Mirginia0/Model-of-Self-Balancing-Multi-Rotor-Beam/ReadMe.md

<h1>Self-Balancing Multi-Rotor Beam</h1>
<p>The goal of this project was to build a self-balancing beam as a laboratory platform for testing and comparing control algorithms. A sensor measures the beam’s tilt angle, while two motor-driven propellers generate differential thrust to control its position.</p>
<p>The physical prototype makes it possible to observe and compare controller responses to reference-angle changes and external disturbances.</p>
<p>Developed as a bachelor’s thesis in Automatic Control and Robotics at Poznan University of Technology (2026).</p>
<p><strong>Authors:</strong> Martyna Rydczak and Maciej Jaśtak<br><strong>Supervisor:</strong> dr inż. Bartłomiej Wicher</p>
<p><strong>ESP32 · C++ · Python · MPU6050 · P/PI control</strong></p>
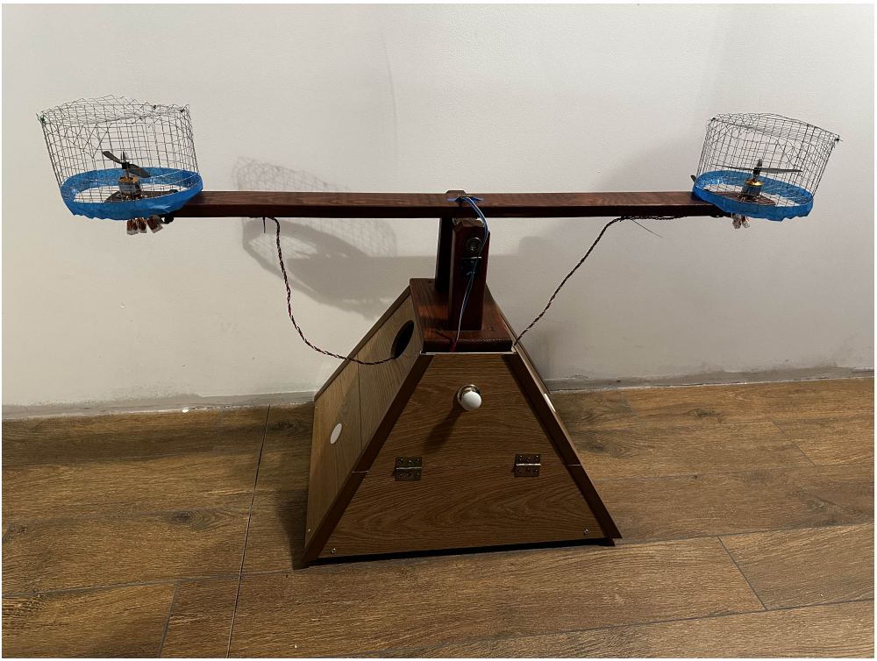
[picture p1: media/images/beam-overview.png]
The assembled beam with motors and protective enclosures

<p>The physical prototype with both propulsion units and protective enclosures.</p>
<h2>See it in action</h2>
<table><tr><th>Experiment</th><th>P controller</th><th>PI controller</th></tr><tr><td>Recovery after deflection</td><td><a href="media/videos/recovery-p.mp4?raw=true">Watch P</a></td><td><a href="media/videos/recovery-pi.mp4?raw=true">Watch PI</a></td></tr><tr><td>Ground-effect disturbance</td><td><a href="media/videos/ground-effect-p.mp4?raw=true">Watch P</a></td><td><a href="media/videos/ground-effect-pi.mp4?raw=true">Watch PI</a></td></tr><tr><td>Reference-angle changes</td><td><a href="media/videos/reference-angle-p.mp4?raw=true">Watch P</a></td><td><a href="media/videos/reference-angle-pi.mp4?raw=true">Watch PI</a></td></tr></table>
<p>Recordings of the three experiments with P and PI control. Links open the MP4 files for playback or download.</p>
<p>The ESP32 estimates beam angle from accelerometer measurements and adjusts both motor commands. A custom Python terminal allows live tuning and records measurements for analysis.</p>
<blockquote><h2>My contribution · Martyna Rydczak</h2>
<p>I was responsible for the electronics, propulsion integration, all software and experimental evaluation.</p>
<p><strong>Hardware integration.</strong> I selected the electronic and propulsion components, assembled and wired the system, and mounted the motors, propellers and protective enclosures on the wooden beam structure. I integrated the MPU6050 sensor with the ESP32 and connected the controller to both ESCs.</p>
<p><strong>Embedded software.</strong> I wrote the complete ESP32 firmware in C++. This included accelerometer-based angle estimation, startup offset calibration, low-pass filtering and the controller that generates differential motor commands. I implemented adjustable gains, individual motor trims, output limits and serial commands for operating and tuning the prototype.</p>
<p><strong>Measurement and evaluation.</strong> I developed the Python terminal and logger to change settings during experiments and record the measured angle, reference angle, controller gains and motor commands. I tuned the P and PI controllers on the physical stand, carried out the tests, collected the data and prepared the plots used to compare their responses. I also created the electronic system and control architecture diagrams in vector graphics.</p>
</blockquote>
<blockquote><p><strong>Maciej Jaśtak’s contribution</strong></p><p>Maciej built the wooden support and beam structure and prepared the mathematical calculations for the joint thesis.</p></blockquote>
<h2>How it works</h2>
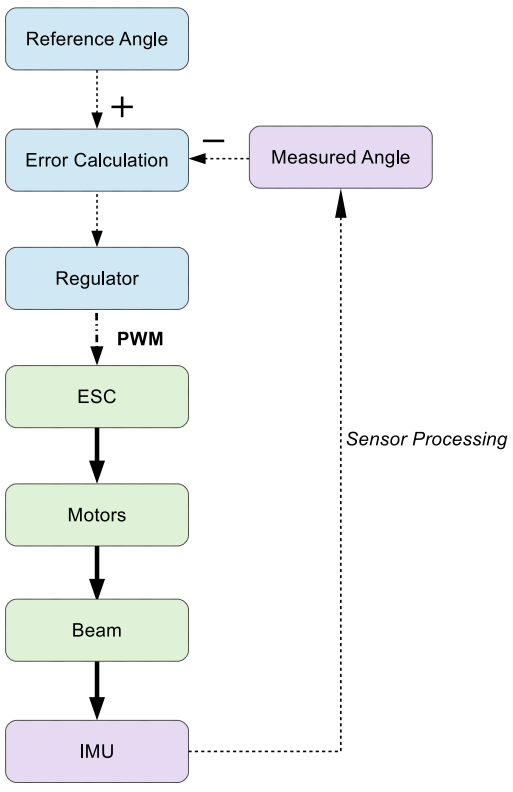
[picture p2: media/images/control-architecture.png]
Control-loop diagram created by Martyna Rydczak
<table><tr><td align="center" valign="middle"></td><td valign="middle"><table><thead><tr><th width="110">Arrow</th><th>Signal type</th></tr></thead><tbody><tr><td nowrap><code>····&gt;</code></td><td>Information signal</td></tr><tr><td nowrap><code>-·-·&gt;</code></td><td>PWM control signal</td></tr><tr><td nowrap><code>━━&gt;</code></td><td>Physical interaction</td></tr></tbody></table></td></tr></table><p>My control-loop diagram from the thesis presentation. The diagram uses reference minus measured angle; the firmware uses measured minus reference with corresponding motor output signs.</p>
<p>The firmware includes startup angle calibration, individual motor trims and adjustable controller gains. The reported experiments used P and PI control with <code>Kd = 0</code>.</p>
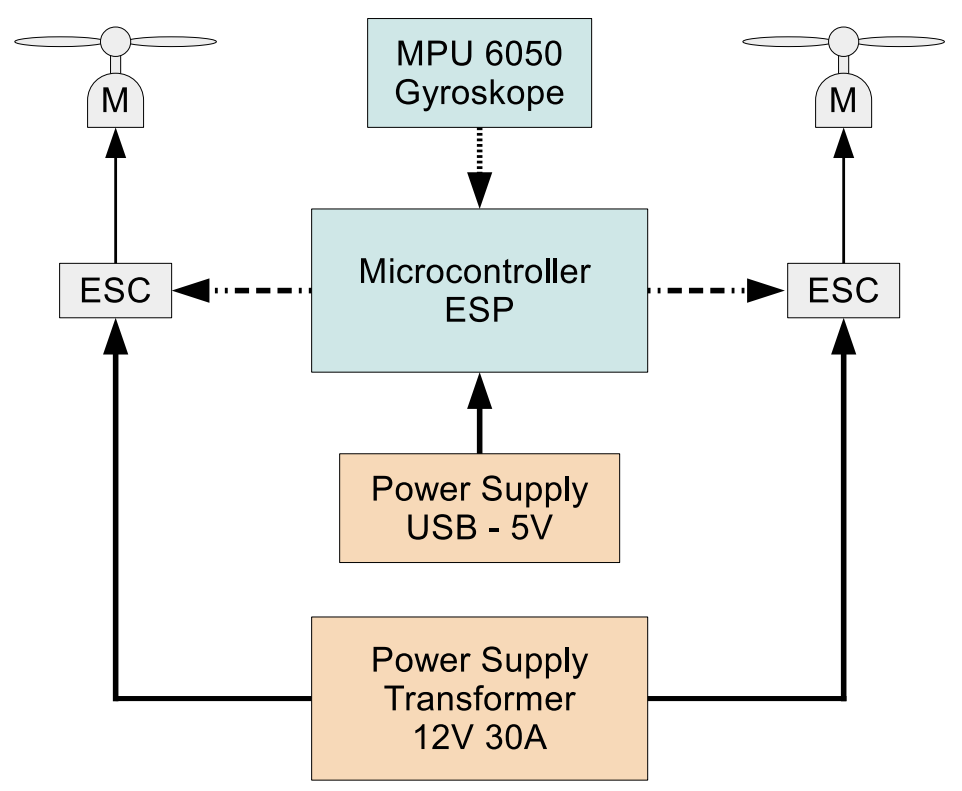
[picture p3: media/images/electronic-design.png]
Electronic system overview created by Martyna Rydczak
<p><strong>Electronic system overview</strong></p><table><tr><td align="center" valign="middle"></td><td valign="middle"><table><thead><tr><th width="110">Arrow</th><th>Signal type</th></tr></thead><tbody><tr><td nowrap><code>━━&gt;</code></td><td>Constant supply voltage</td></tr><tr><td nowrap><code>──&gt;</code></td><td>Power signal</td></tr><tr><td nowrap><code>····&gt;</code></td><td>I²C digital data</td></tr><tr><td nowrap><code>-·-·&gt;</code></td><td>PWM control signal</td></tr></tbody></table></td></tr></table><p>My electronic system diagram. The MPU6050 label in the original illustration refers to the IMU module; angle estimation in the experiments used its accelerometer.</p>
<hr>

<details><summary><strong>Electronic design · Connection schematics</strong></summary>
<p>I selected and connected the electronic components, integrating the ESP32, MPU6050 and both motor controllers. These schematic excerpts from the thesis presentation document the signal connections and propulsion wiring.</p>
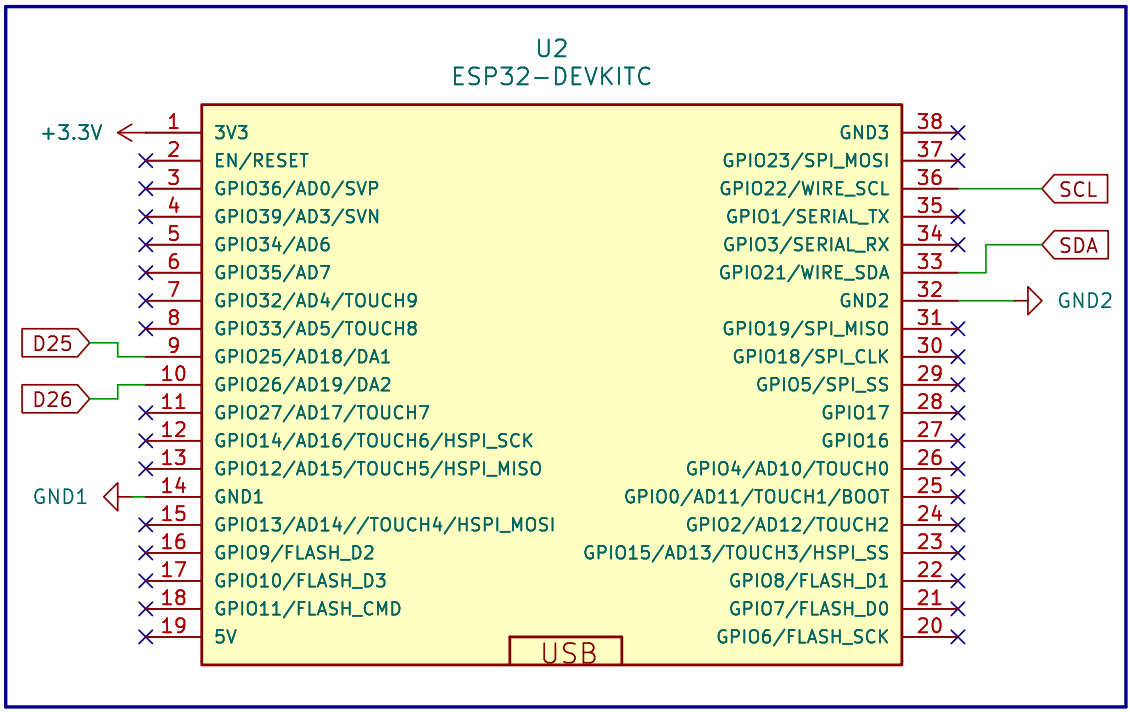
[picture p4: media/images/esp32-connections.png]
ESP32 connection schematic from the thesis presentation
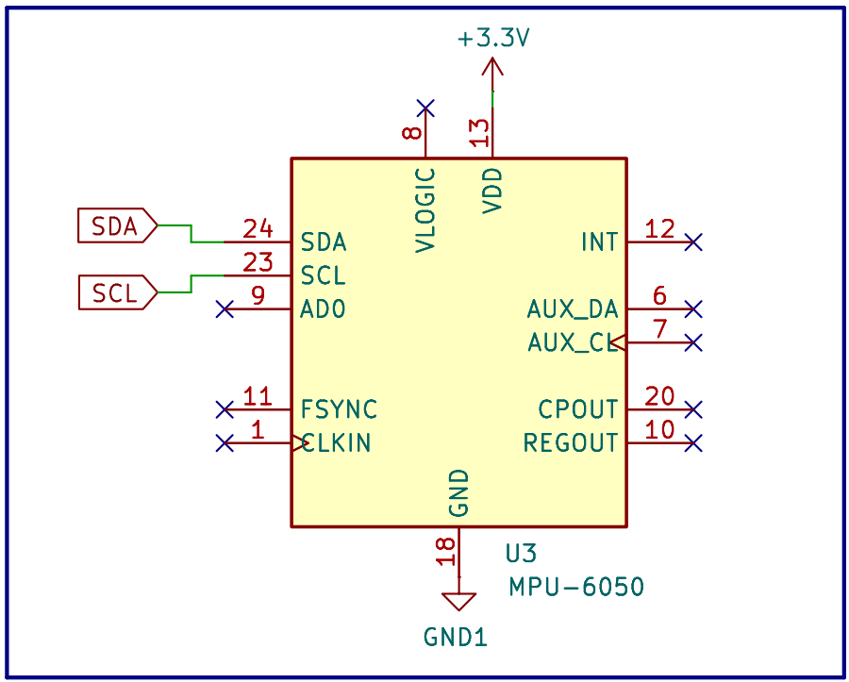
[picture p5: media/images/imu-connections.png]
MPU6050 connection schematic from the thesis presentation
<table><tr><th>ESP32 connections</th><th>MPU6050 connections</th></tr><tr><td></td><td></td></tr></table>
<p><strong>ESC and motor connections</strong></p>
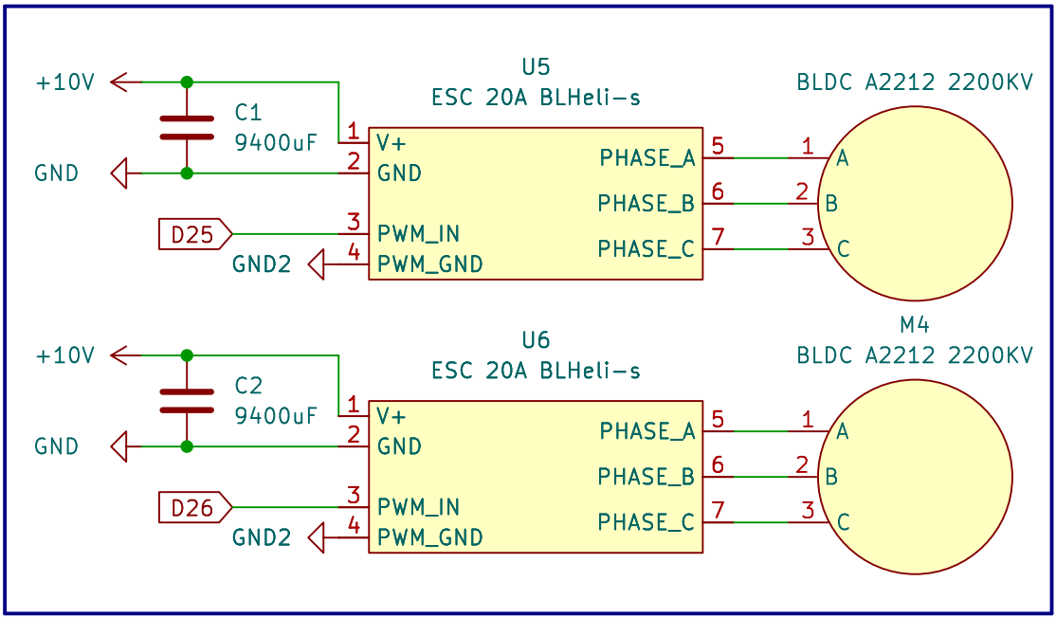
[picture p6: media/images/esc-motor-connections.png]
Connection schematic showing both ESCs, motors and capacitors

<p>Schematic excerpts from the presentation; these do not constitute a complete wiring guide.</p>
</details>

<h2>Experiments and results</h2>
<p>I compared P and PI control on the physical prototype using three test scenarios. The recorded angle and motor commands showed how each controller responded to disturbances and changes in the reference.</p>
<p><strong>Recovery after a large deflection.</strong> After manually deflecting and releasing the beam, both controllers returned it towards the horizontal reference. P control showed faster decay of the oscillations but retained a small steady-state offset. PI control removed the residual offset in the reported test, with a longer settling time.</p>

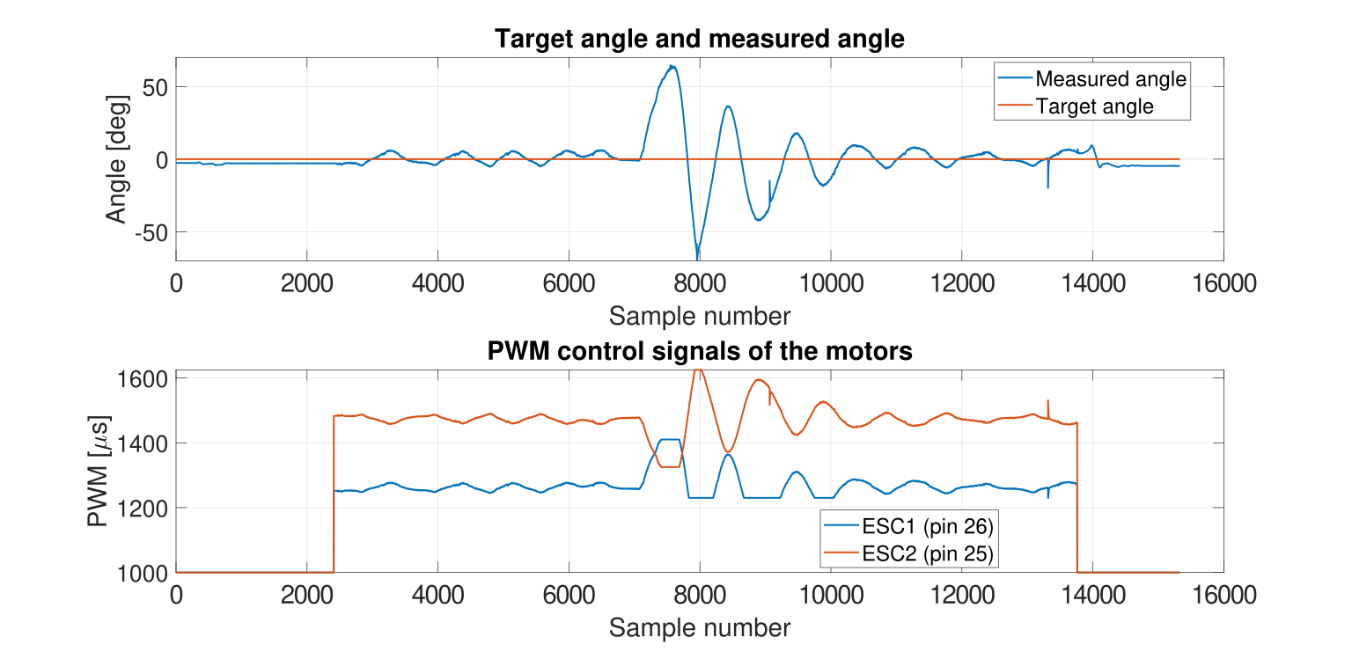
[picture p7: media/images/recovery-p-plot.png]
Recovery after deflection: P controller angle and PWM plots
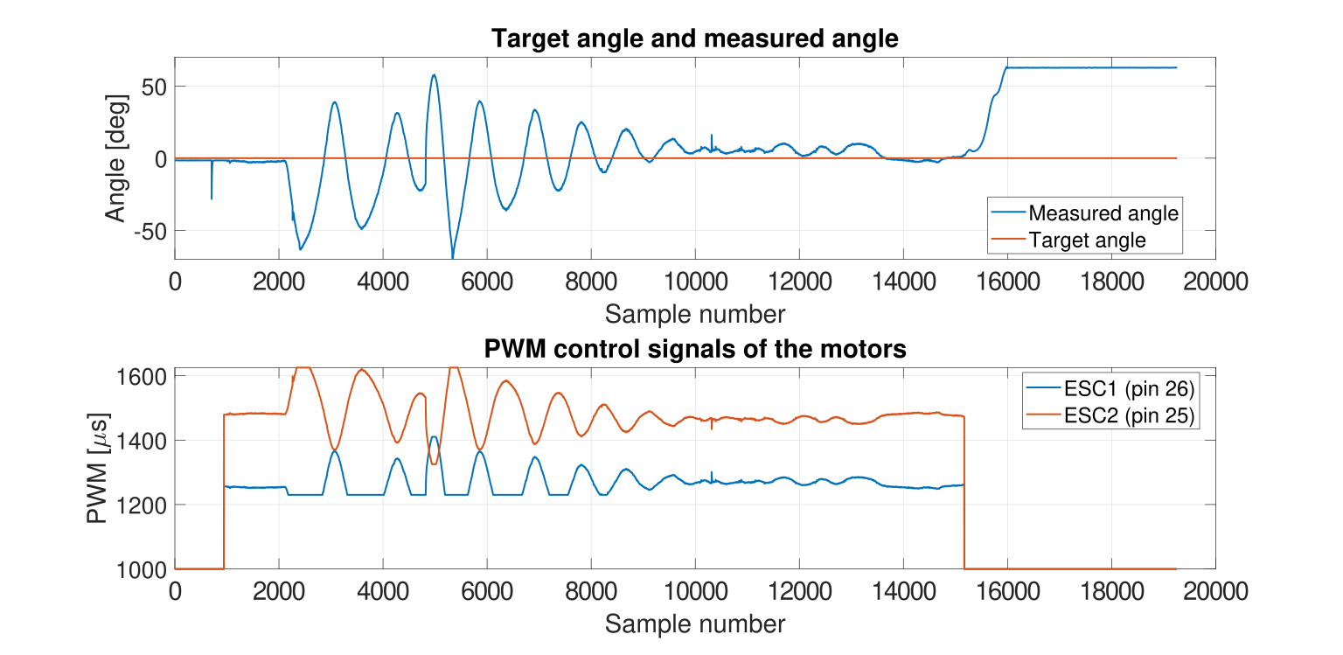
[picture p8: media/images/recovery-pi-plot.png]
Recovery after deflection: PI controller angle and PWM plots
<table><tr><th>P controller · Recovery after deflection</th><th>PI controller · Recovery after deflection</th></tr><tr><td></td><td></td></tr></table>
<p><strong>Ground-effect disturbance.</strong> Placing a flat surface below one rotor changed its thrust and disturbed the balance. With P control, a persistent deviation from the reference remained. With PI control, the deviation became a transient response and the beam returned towards the horizontal reference. The plots below illustrate this difference.</p>

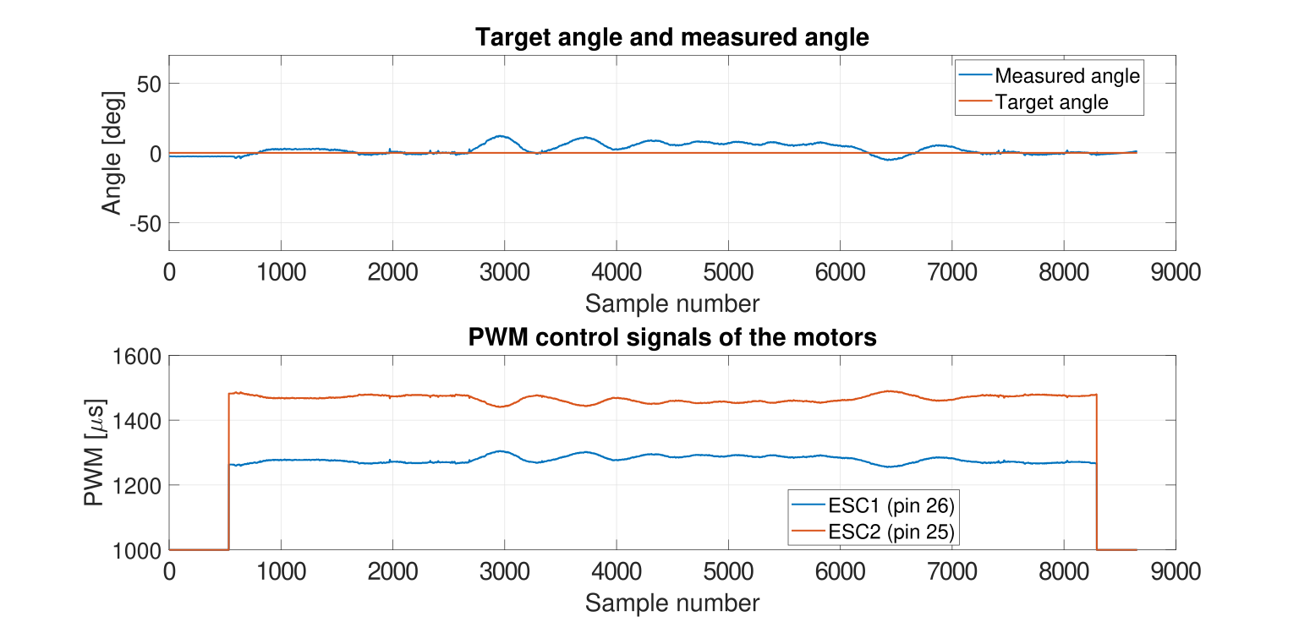
[picture p9: media/images/ground-effect-p-plot.png]
P controller response to ground effect
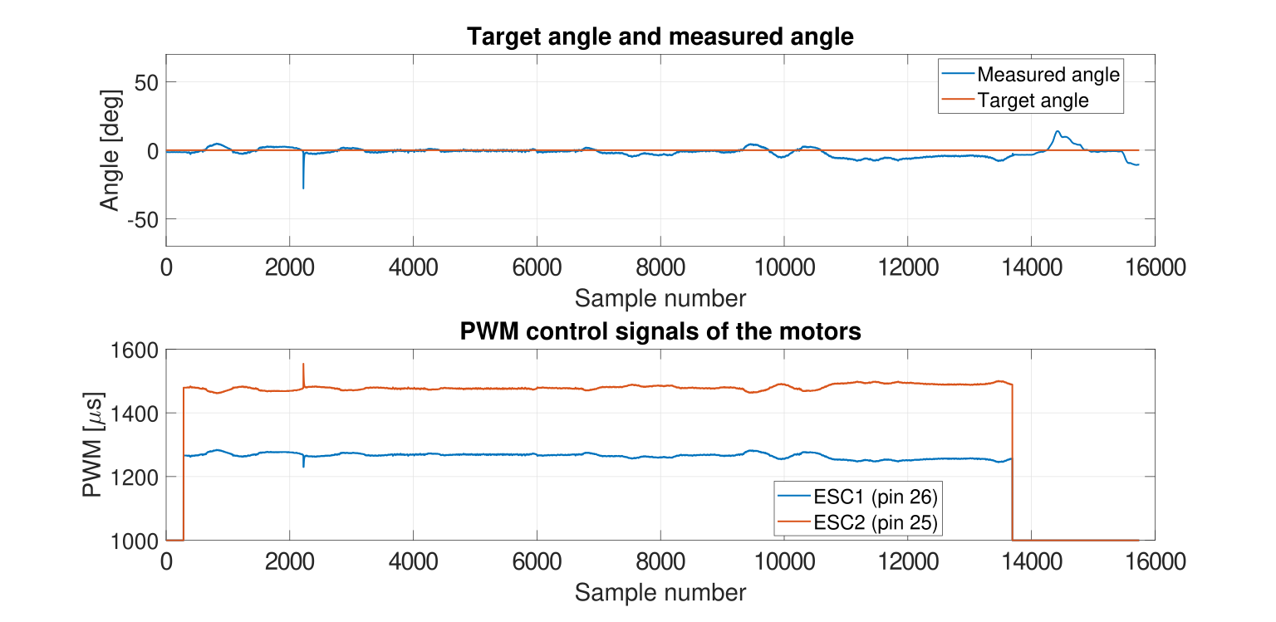
[picture p10: media/images/ground-effect-pi-plot.png]
PI controller response to ground effect
<table><tr><th>P controller · Ground effect</th><th>PI controller · Ground effect</th></tr><tr><td></td><td></td></tr></table>
<p><strong>Reference-angle changes.</strong> The beam was commanded from 0° to +20°, back to 0°, then to −40° and back to 0°. P control followed the changes but retained tracking offsets and oscillations. PI control converged closer to the commanded angles, although transient oscillations remained after larger changes.</p>

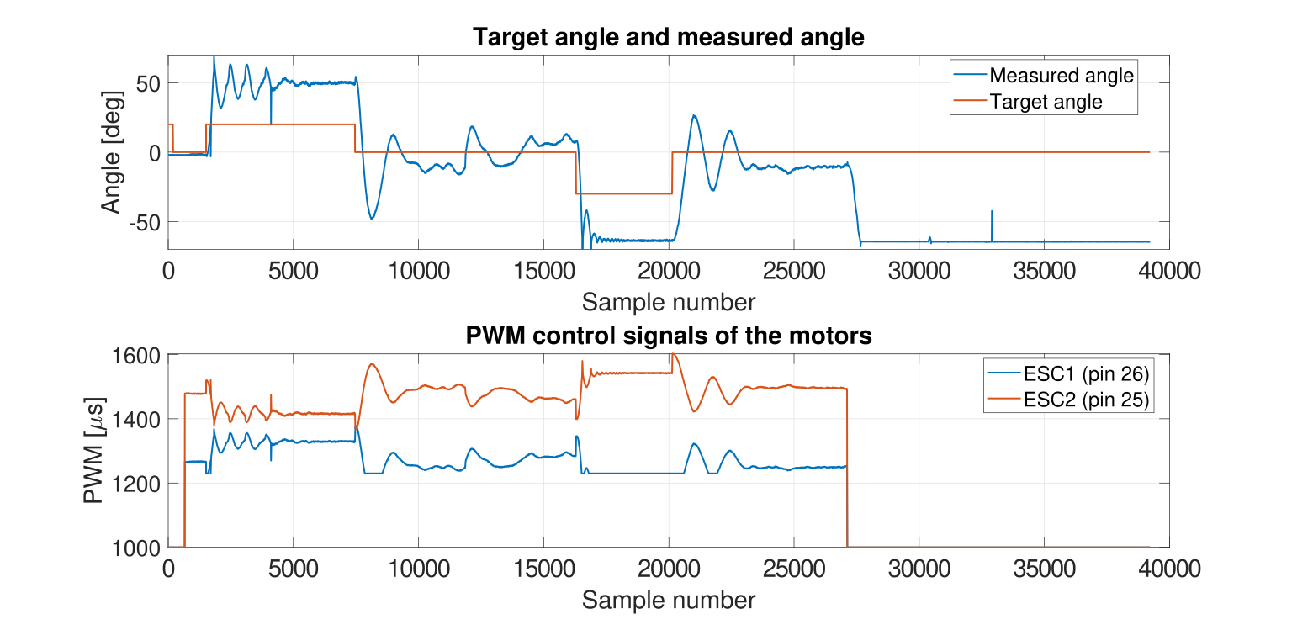
[picture p11: media/images/reference-p-plot.png]
Reference-angle changes: P controller angle and PWM plots
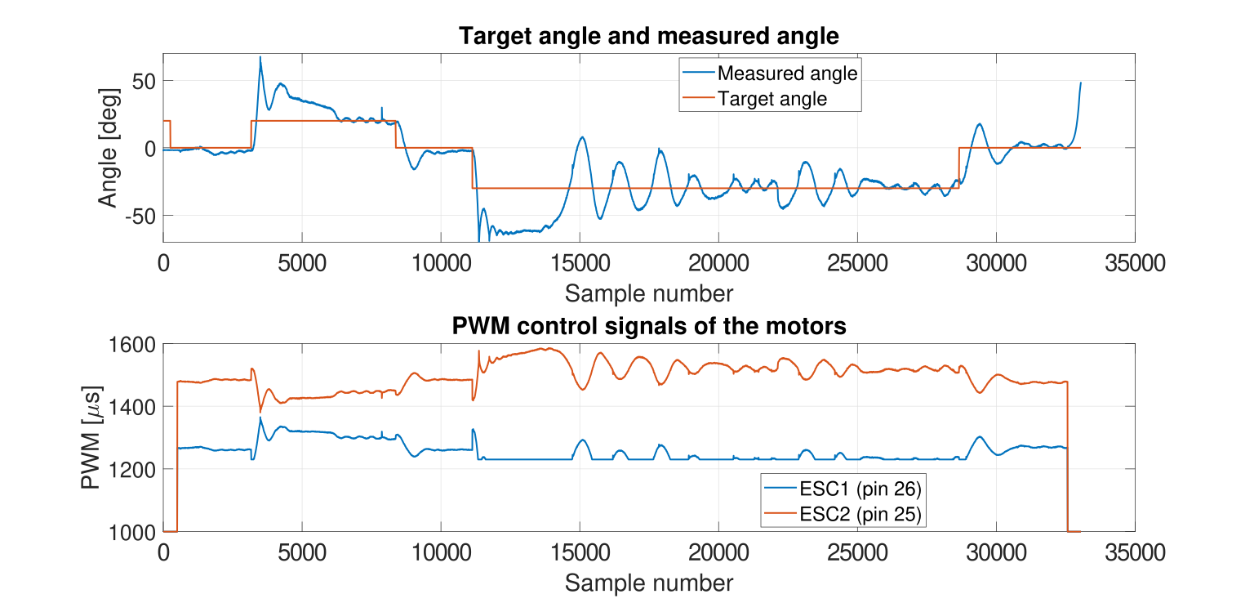
[picture p12: media/images/reference-pi-plot.png]
Reference-angle changes: PI controller angle and PWM plots
<table><tr><th>P controller · Reference-angle changes</th><th>PI controller · Reference-angle changes</th></tr><tr><td></td><td></td></tr></table>
<p><strong>Actuator asymmetry.</strong> Equal PWM commands did not produce balanced operation of the two propulsion units. I compensated for this using individual trims of −105 µs and +125 µs. This improved equilibrium behaviour and highlighted the need to calibrate the physical actuators.</p>
<p><strong>What the experiments showed.</strong> Integral action improved steady-state accuracy and rejection of a sustained disturbance, while P control recovered faster in the deflection test. Neither tested configuration provided sufficient damping throughout the experiments. Evaluating the existing derivative term is a potential next step; it was disabled during these tests.</p>
<p>Original plots use sample number on the horizontal axis.</p>

<hr>

<details><summary><strong>Hardware and software</strong></summary><ul><li>ESP32, MPU6050 and two A2212 2200KV brushless motors</li><li>Two BLHeli-S 20 A ESCs and EP-6030 propellers</li><li>Arduino firmware: Adafruit MPU6050, Adafruit Unified Sensor, ESP32Servo</li><li>Python terminal: pyserial and prompt_toolkit</li></ul><p>Exact library versions were not recorded.</p></details>

<hr>

<details><summary><strong>Running the project</strong></summary><p>Upload <code>Self-Balancing_Beam/Self-Balancing_Beam.ino</code> using an Arduino environment configured for the ESP32. Keep the beam horizontal during startup calibration.</p><pre>python -m pip install pyserial prompt_toolkit
python Logger.py</pre><p>Set the serial port in <code>Logger.py</code>. Communication uses 115200 baud. Send <code>x</code> before exiting: <code>quit</code> closes the terminal without stopping the motors.</p></details>

<hr>

<details><summary><strong>Limitations and further development</strong></summary><p>Accelerometer angle estimation is affected by vibrations. Tuning and motor trims are specific to the prototype. Derivative control is implemented but was not evaluated in the reported experiments. Potential extensions include improved sensor estimation and automated test sequences.</p></details>

<hr>

<h2>Project files</h2>
<p>Browse the <a href="media/README.md">project images, diagrams and test recordings</a>, or the <a href="data/README.md">raw measurements and original EPS plots</a>.</p>
