Mirginia0/Model-of-Self-Balancing-Multi-Rotor-Beam/media/README.md

# Project media

## Folder structure

- `images/`: the photograph, diagrams, connection schematics and six result plots displayed in the main README.
- `videos/`: MP4 test recordings. The reference-angle PI recording is a compressed H.264/AAC copy of the supplied file, without trimming. The other recordings preserve the supplied files.

## Experiment recordings

| Experiment | P controller | PI controller |
|---|---|---|
| Recovery after maximum deflection | [Video](videos/recovery-p.mp4?raw=true) | [Video](videos/recovery-pi.mp4?raw=true) |
| Ground-effect disturbance | [Video](videos/ground-effect-p.mp4?raw=true) | [Video](videos/ground-effect-pi.mp4?raw=true) |
| Reference-angle changes | [Video](videos/reference-angle-p.mp4?raw=true) | [Video](videos/reference-angle-pi.mp4?raw=true) |

Links provide direct access to the MP4 files. Depending on the browser, files may play or download. Large files may not preview on GitHub's file page.

The supplied file `Change P (1of2).MP4` is the P experiment, and `Change P (2of2).MP4` is the PI experiment, as confirmed by Martyna Rydczak. Their repository filenames reflect the controller used rather than the original misleading part labels.

The diagrams were created by Martyna Rydczak. See the main README for the project contribution breakdown.
